saidhann/Stoper/timer/output.pdf

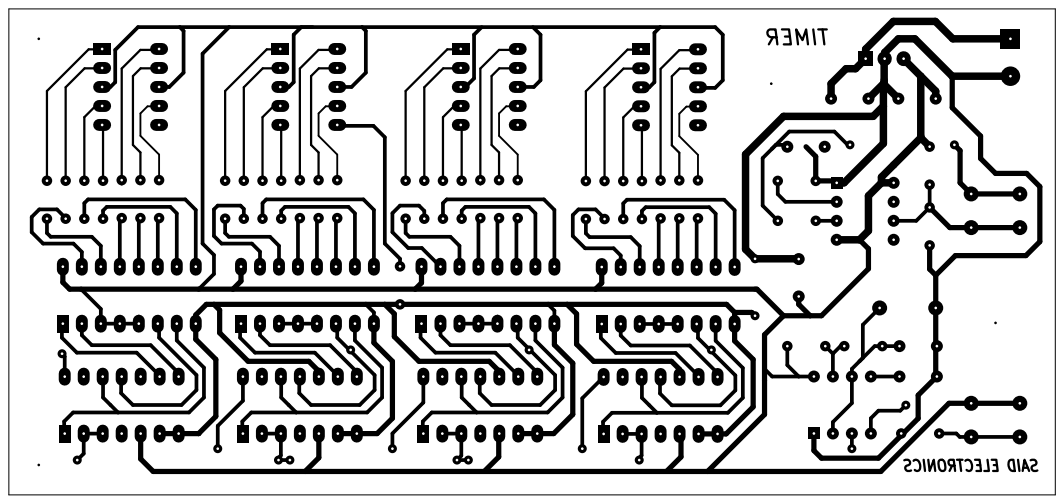
[picture p4: page 1]
