saidhann/Stoper/timer/TimerS.kicad_pcb

## KiCad design timer/TimerS.kicad_pcb (2024-02-29)

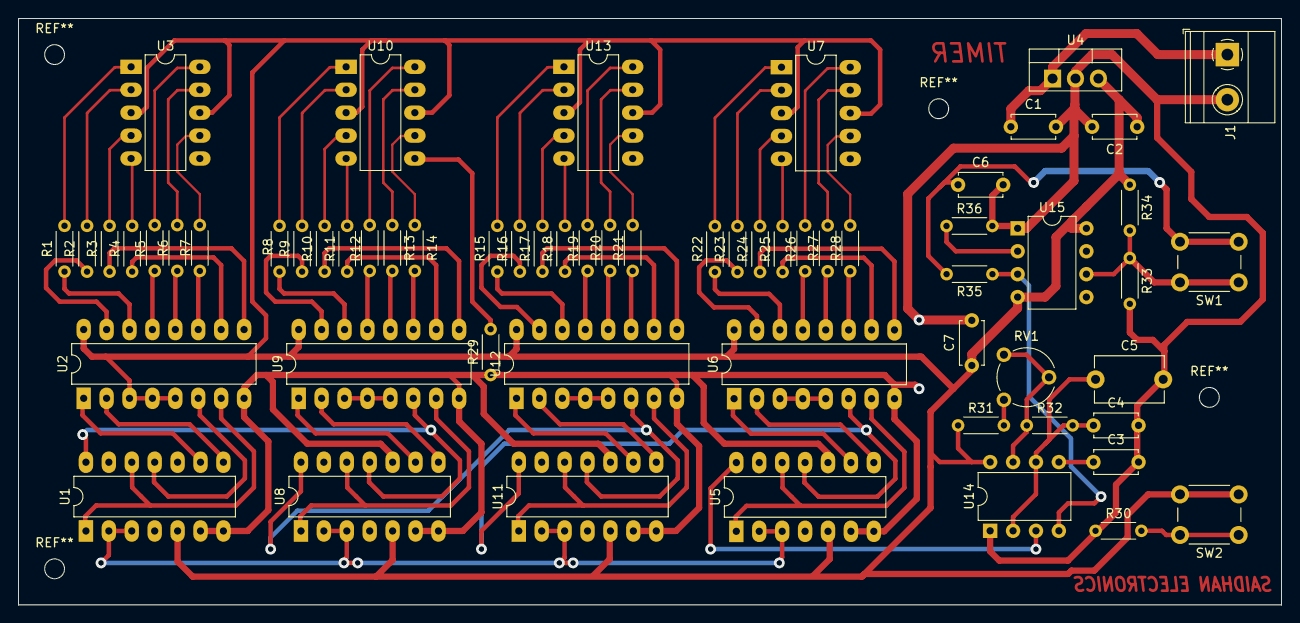
[picture p5: board TimerS.kicad_pcb from above]

Board: 2 copper layers, 140.0 x 65.0 mm, 62 parts (0 on the bottom side), 85 nets.

Parts:
C1, C2, C3: 10n; C_Disc_D4.7mm_W2.5mm_P5.00mm
C4: 47n; C_Disc_D4.7mm_W2.5mm_P5.00mm
C5: 470n; C_Disc_D7.5mm_W5.0mm_P7.50mm
C6: 470n; C_Disc_D4.7mm_W2.5mm_P5.00mm
C7: 1u; C_Disc_D4.7mm_W2.5mm_P5.00mm
J1: Power; TerminalBlock_Phoenix_MKDS-1,5-2_1x02_P5.00mm_Horizontal
R1, R2, R3, R4, R5, R6, R7, R8, R9, R10, R11, R12, R13, R14, R15, R16, R17, R18, R19, R20, R21, R22, R23, R24, R25, R26, R27, R28, R29, R30: 1k; R_Axial_DIN0204_L3.6mm_D1.6mm_P5.08mm_Horizontal
R31, R32, R33, R34, R35, R36: 100k; R_Axial_DIN0204_L3.6mm_D1.6mm_P5.08mm_Horizontal
RV1: R_Potentiometer; Potentiometer_Piher_PT-6-V_Vertical
SW1: Start/Stop; SW_PUSH_6mm_H5mm
SW2: Reset; SW_PUSH_6mm_H5mm
U1, U5, U8, U11: 74LS90; DIP-14_W7.62mm_LongPads
U2, U6, U9, U12: 74LS47; DIP-16_W7.62mm_LongPads
U3, U7, U10, U13: DIP-10_W7.62mm_LongPads
U4: L7805; TO-220-3_Vertical
U14, U15: NA555P; DIP-8_W7.62mm

Connections:
+5V: C2.1, C7.1, R31.1, R34.1, SW2.2 (B), U1.5 (VCC), U2.3 (LT), U2.4 (BI), U2.5 (RBI), U2.16 (VCC), U3.3 (A), U3.8 (A), U4.3 (OUT), U5.5 (VCC), U6.3 (LT), U6.4 (BI), U6.5 (RBI), U6.16 (VCC), U7.3 (A), U7.8 (A), U8.5 (VCC), U9.3 (LT), U9.4 (BI), U9.5 (RBI), U9.16 (VCC), U10.3 (A), U10.8 (A), U11.5 (VCC), U12.3 (LT), U12.4 (BI), U12.5 (RBI), U12.16 (VCC), U13.3 (A), U13.8 (A), U14.8 (VCC), U15.4 (R), U15.8 (VCC)
/Digit_Section1/CLK_OUT: U5.11 (Q3), U6.6 (D), U11.14 (CP0)
/Digit_Section2/CLK_IN: U8.14 (CP0), U11.11 (Q3), U12.6 (D)
/Digit_Section2/DP: R29.2, U10.6 (dp)
/Digit_Section/CLK_IN: U1.14 (CP0), U8.11 (Q3), U9.6 (D)
/Digit_Section/CLK_OUT: U1.11 (Q3), U2.6 (D)
/Digit_Section/RST: R30.2, SW2.1 (A), U1.2 (R0(1)), U1.3 (R0(2)), U5.2 (R0(1)), U5.3 (R0(2)), U8.2 (R0(1)), U8.3 (R0(2)), U11.2 (R0(1)), U11.3 (R0(2))
CLK: U5.14 (CP0), U14.3 (Q)
GND: C1.2, C2.2, C3.2, C4.2, C5.2, C6.2, C7.2, J1.2, R29.1, R30.1, R33.2, R36.2, U1.6 (R9(1)), U1.7 (R9(2)), U1.10 (GND), U2.8 (GND), U4.2 (GND), U5.6 (R9(1)), U5.7 (R9(2)), U5.10 (GND), U6.8 (GND), U8.6 (R9(1)), U8.7 (R9(2)), U8.10 (GND), U9.8 (GND), U11.6 (R9(1)), U11.7 (R9(2)), U11.10 (GND), U12.8 (GND), U14.1 (GND), U15.1 (GND)
unnamed: C1.1, J1.1, U4.1 (IN)
unnamed: R31.2, RV1.1
unnamed: R33.1, R34.2, R36.1, SW1.1 (A), U15.2 (TR), U15.6 (THR)
unnamed: C6.1, R35.2, SW1.2 (B)
unnamed: U1.1 (CP1..3), U1.12 (Q0), U2.7 (A)
unnamed: U1.9 (Q1), U2.1 (B)
unnamed: U1.8 (Q2), U2.2 (C)
unnamed: R5.2, U2.13 (a)
unnamed: R6.2, U2.12 (b)
unnamed: R7.2, U2.11 (c)
unnamed: R4.1, U2.10 (d)
unnamed: R3.1, U2.9 (e)
unnamed: R2.1, U2.15 (f)
unnamed: R1.1, U2.14 (g)
unnamed: R5.1, U3.10 (a)
unnamed: R6.1, U3.9 (b)
unnamed: R7.1, U3.7 (c)
unnamed: R4.2, U3.5 (d)
unnamed: R3.2, U3.4 (e)
unnamed: R2.2, U3.2 (f)
unnamed: R1.2, U3.1 (g)
unnamed: U5.1 (CP1..3), U5.12 (Q0), U6.7 (A)
unnamed: U5.9 (Q1), U6.1 (B)
unnamed: U5.8 (Q2), U6.2 (C)
unnamed: R26.2, U6.13 (a)
unnamed: R27.2, U6.12 (b)
unnamed: R28.2, U6.11 (c)
unnamed: R25.1, U6.10 (d)
unnamed: R24.1, U6.9 (e)
unnamed: R23.1, U6.15 (f)
unnamed: R22.1, U6.14 (g)
unnamed: R26.1, U7.10 (a)
unnamed: R27.1, U7.9 (b)
unnamed: R28.1, U7.7 (c)
unnamed: R25.2, U7.5 (d)
unnamed: R24.2, U7.4 (e)
unnamed: R23.2, U7.2 (f)
unnamed: R22.2, U7.1 (g)
unnamed: U8.1 (CP1..3), U8.12 (Q0), U9.7 (A)
unnamed: U8.9 (Q1), U9.1 (B)
unnamed: U8.8 (Q2), U9.2 (C)
unnamed: R12.2, U9.13 (a)
unnamed: R13.2, U9.12 (b)
unnamed: R14.2, U9.11 (c)
unnamed: R11.1, U9.10 (d)
unnamed: R10.1, U9.9 (e)
unnamed: R9.1, U9.15 (f)
unnamed: R8.1, U9.14 (g)
unnamed: R12.1, U10.10 (a)
unnamed: R13.1, U10.9 (b)
unnamed: R14.1, U10.7 (c)
unnamed: R11.2, U10.5 (d)
unnamed: R10.2, U10.4 (e)
unnamed: R9.2, U10.2 (f)
unnamed: R8.2, U10.1 (g)
unnamed: U11.1 (CP1..3), U11.12 (Q0), U12.7 (A)
unnamed: U11.9 (Q1), U12.1 (B)
unnamed: U11.8 (Q2), U12.2 (C)
unnamed: R19.2, U12.13 (a)
unnamed: R20.2, U12.12 (b)
unnamed: R21.2, U12.11 (c)
unnamed: R18.1, U12.10 (d)
unnamed: R17.1, U12.9 (e)
unnamed: R16.1, U12.15 (f)
unnamed: R15.1, U12.14 (g)
unnamed: R19.1, U13.10 (a)
unnamed: R20.1, U13.9 (b)
unnamed: R21.1, U13.7 (c)
unnamed: R18.2, U13.5 (d)
unnamed: R17.2, U13.4 (e)
unnamed: R16.2, U13.2 (f)
unnamed: R15.2, U13.1 (g)
unnamed: C3.1, U14.5 (CV)
unnamed: R32.1, RV1.2, RV1.3, U14.7 (DIS)
unnamed: R35.1, U14.4 (R), U15.3 (Q)
unnamed: C4.1, C5.1, R32.2, U14.2 (TR), U14.6 (THR)
