saidhann/Stoper/(commit log)

2024-02-29 Adding stoper project
    [timer.kicad_pcb, timer.kicad_sch]
2024-02-29 Adding new version
    [TimerS.kicad_pcb, TimerS.kicad_sch, digit.kicad_sch]
